jvanderberg/usb-pd/README.md

# usb-pd

A pocket USB-C PD/PPS bench supply, 67 x 17 mm. Plug it into a PD charger and pick a fixed voltage. With a PPS
charger, set any voltage from 5 to 21 V in 100 mV steps, plus a current limit. Switch the output on and off and read
volts, amps and board temperature on a tiny OLED.

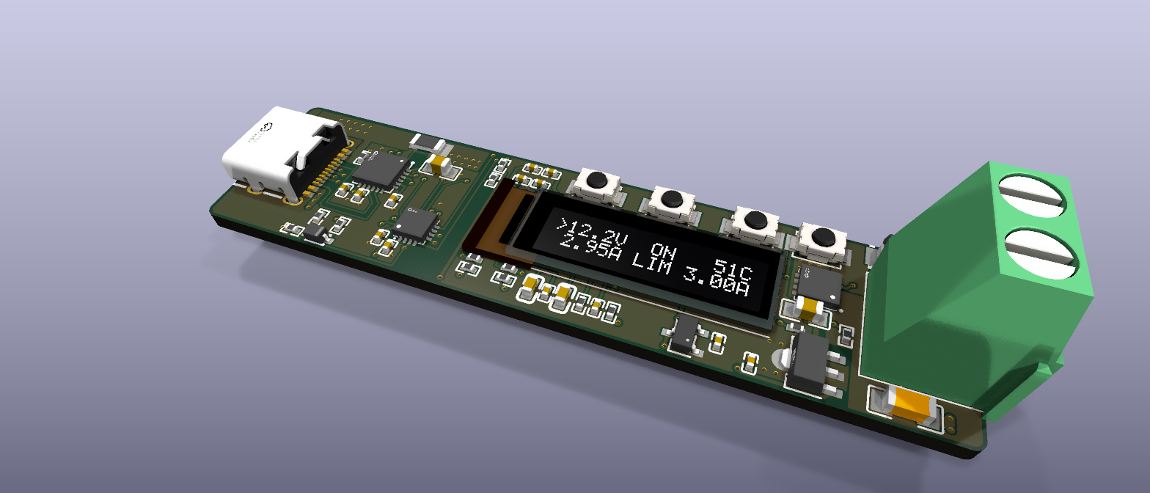
[picture p1: docs/images/board-3d.png]
3D render of the board


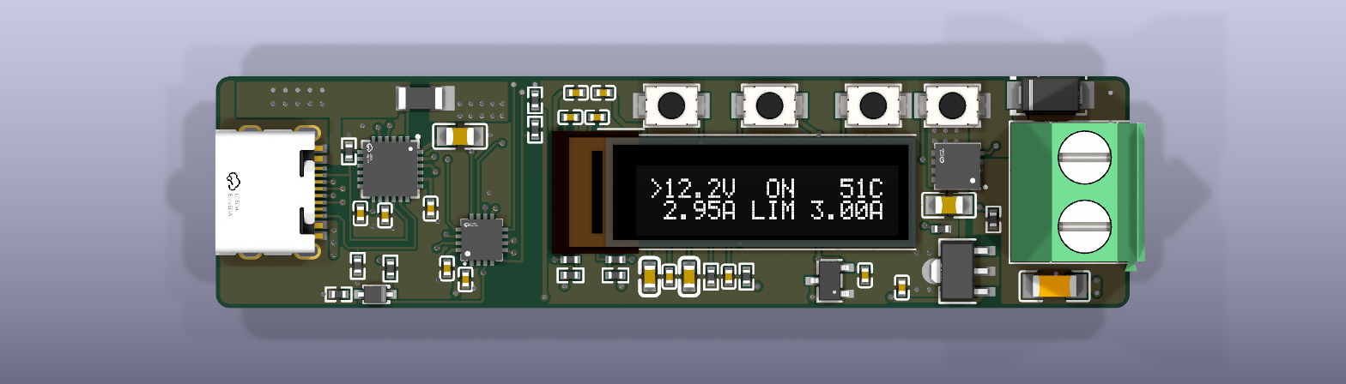
[picture p2: docs/images/board-top.png]
Top view


*KiCad 3D renders. The 0.69" OLED is hand-soldered by its flex cable and folded over onto the board. Its model
(`tools/oled_3d.py`) is built from the panel's outline drawing and shows a real frame from the firmware.*

## The screen

What the firmware draws, rendered on the host from the real UI and OLED code through a model of the panel's memory
(`cd firmware && make screens`):

| | |
|---|---|
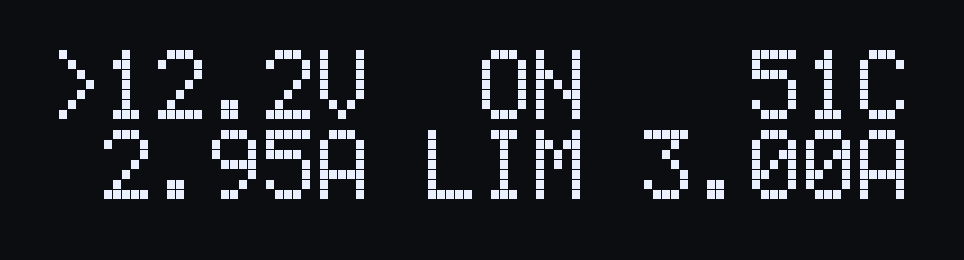
[picture p3: docs/images/screen-pps-on.png]
pps on
| PPS, output on: voltage, temperature, current, current limit |  |
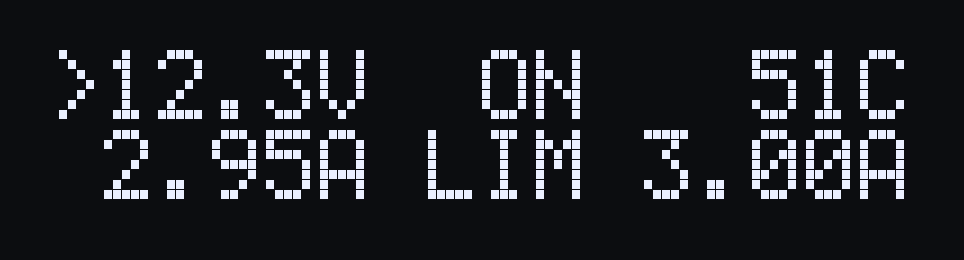
[picture p4: docs/images/screen-pps-set-v.png]
pps set v
| PPS, editing the voltage (`>` marks the value being edited) |  |
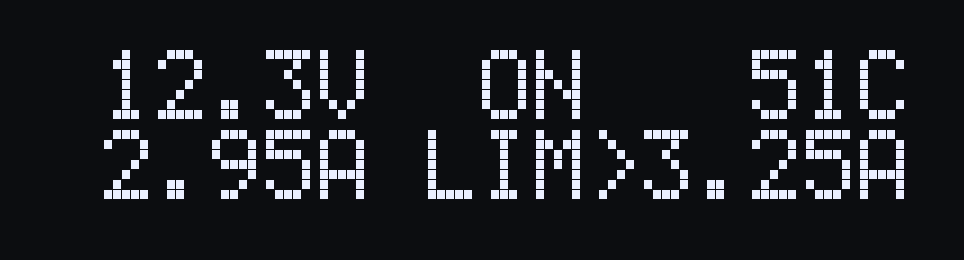
[picture p5: docs/images/screen-pps-set-i.png]
pps set i
| PPS, editing the current limit (UP + DOWN switches) |  |
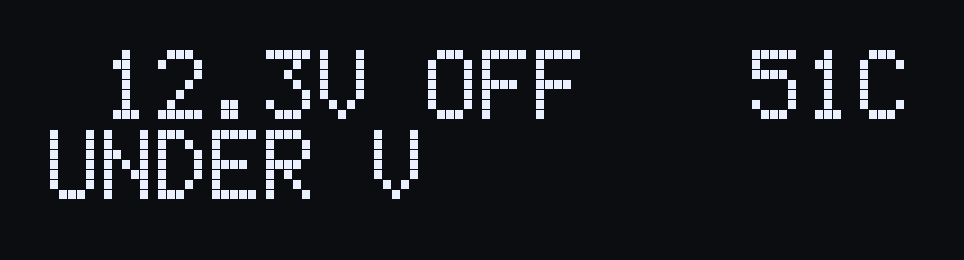
[picture p6: docs/images/screen-pps-uvp.png]
pps uvp
| PPS, undervoltage trip (e.g. the charger hit its current limit) |  |
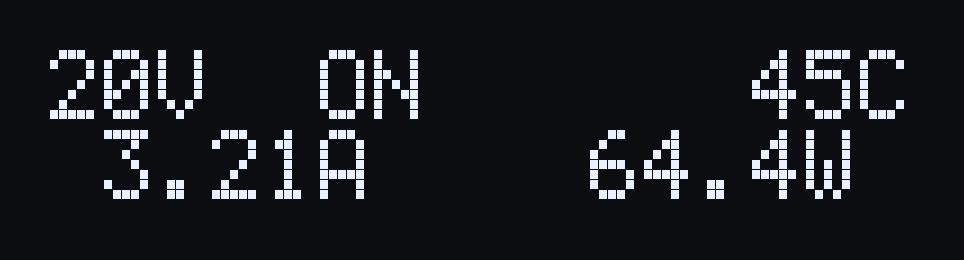
[picture p7: docs/images/screen-on.png]
on
| Fixed voltage, output on |  |
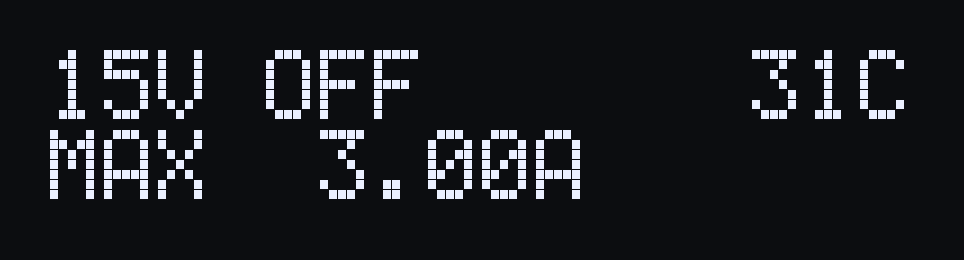
[picture p8: docs/images/screen-off.png]
off
| Fixed voltage, output off |  |
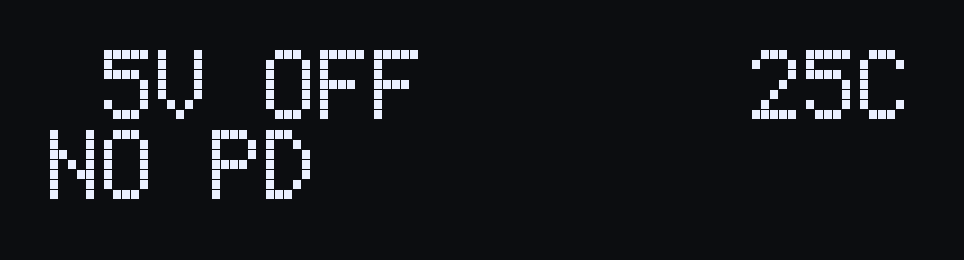
[picture p9: docs/images/screen-no-pd.png]
no PD
| No PD charger (plain 5 V) |  |
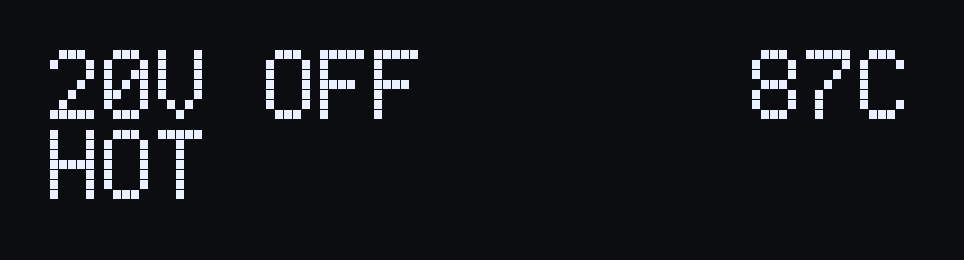
[picture p10: docs/images/screen-hot.png]
hot
| Thermal cutoff |  |
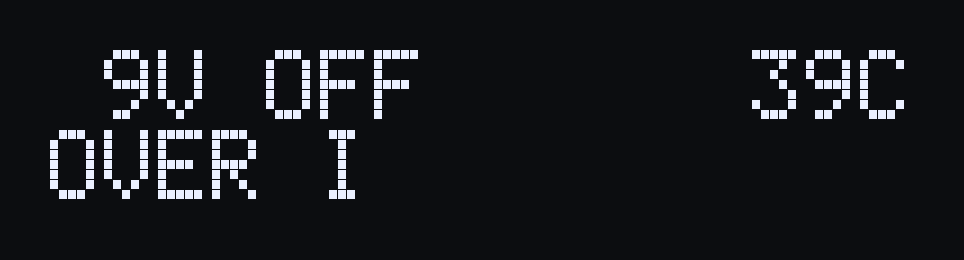
[picture p11: docs/images/screen-overcurrent.png]
over-current
| Over-current trip |  |

## What it does

- **PD sink:** AP33772S (AP33772SDKZ-13-FA02). It negotiates the charger's fixed voltages and PPS up to 21 V, and
  never requests what the charger does not offer. EPR is disabled in firmware.
- **Buttons:** four, in one row: `[ON]  [SEL]  [UP][DN]`.
  - ON switches the output on and off.
  - SEL steps through the fixed voltages the charger offers, then PPS, turning the output off first.
  - In PPS, UP / DOWN change the setpoint (hold to accelerate), and UP + DOWN together switch between voltage and
    current limit.
- **Display:** voltage, current and NTC temperature, all read from the AP33772S.
- **Memory:** remembers the last voltage or PPS setpoint and the on/off state, wear-levelled in the MCU's DataFlash.
- **Protection:** the AP33772S's OCP / OVP / UVP / OTP, plus the firmware's own thermal trip (board NTC and a
  MOSFET temperature estimate).
- **Firmware updates** over the same USB-C port (CH552 ROM bootloader).

## Hardware

- 67 x 17 mm, 2 layers, all parts on top, made for JLCPCB economic assembly.
- **ICs:** CH552P MCU and AP33772S PD sink, with SGM2203 (5 V) and XC6206 (3.3 V) regulators.
- **Output switch:** one AON7262E N-MOSFET driven by the AP33772S, with an SS34 clamp and 10 uF on the output, as on
  CentyLab's RotoPD.
- **I2C:** the MCU talks to the AP33772S on its own 5 V bus and to the OLED on a 3.3 V bus.
- **Output:** two 5.08 mm through-hole pads, for a screw terminal or wires.
- **Design method:** designed in KiCad 10 from scripts with [kicad-skills](https://github.com/jvanderberg/kicad-skills).
  The schematic, netlist, placement and routing are generated by `tools/` (`tools/build_board.sh`).

Read these before building one:
- [docs/requirements.md](docs/requirements.md): requirements, decisions, block diagram and parts.
- [docs/design-review.md](docs/design-review.md): the design review, including its main limit. The board is
  small, so 100 W continuous makes it too hot; the thermal trips are what protect it.

Production files for JLCPCB (gerbers, BOM, CPL, part check) for 10 boards are in `production/`. To regenerate them:
`jlcimport-cli production hardware/usbpd.kicad_pcb -n 10 -o production`.

## Firmware

C for SDCC, in [firmware/](firmware/). See [firmware/README.md](firmware/README.md).

```
cd firmware
make          # build/usbpd.hex and .bin
make test     # host tests
make screens  # the screen images above
make flash    # wchisp, with the board in its bootloader (hold SEL while plugging in)
```

## Status

Designed, not yet built. The board passes DRC, ERC and the design review, and the firmware passes its host tests,
but nothing has run on real hardware. Known open items before or at bring-up:
- **Firmware:** confirm that "output off" took effect by reading `SYSTEM` back, at boot and on every trip.
- **Bring-up:** measure Q1's gate drive and on-resistance, and check that JLC placed the polarised parts correctly.
- **Behaviour:** when a PPS charger hits its current limit, the output trips on undervoltage instead of holding a
  constant current.

This is a hobby project, not designed or reviewed for safety-critical use.

Created in [T3 Code](https://t3.codes).
