jvanderberg/usb-pd/production/usbpd-bom.csv

Comment | Designator | Footprint | JLCPCB Part #
1u 50V | C1,C2 | CL21B105KBFNNNE | C28323
4.7u | C3,C13 | CL05A475MP5NRNC | C23733
1u | C4,C7,C8,C15 | CL05A105KA5NQNC | C52923
100n | C5,C6,C9,C12,C14,C16,C17 | CL05B104KO5NNNC | C1525
2.2u 16V | C10 | CL10A225KO8NNNC | C23630
4.7u 25V | C11 | CL10A475KA8NQNC | C69335
10u 50V | C18 | CL31A106KBHNNNE | C13585
BAT54WS | D1 | BAT54WS_C7502694 | C7502694
SS34 | D2 | SS34_C8678 | C8678
TYPE-C-31-M-12 | J1 | TYPE-C-31-M-12 | C165948
AON7262E | Q1 | AON7262E | C176755
2.2k | R1,R2 | 0402WGF2201TCE | C25879
10k | R3,R4,R9 | 0402WGF1002TCE | C25744
5.1k | R5,R6 | 0402WGF5101TCE | C25905
4.7k | R7,R8 | 0402WGF4701TCE | C25900
5m | R10 | RLM12FTCMR005 | C316225
910k | R11 | 0402WGF9103TCE | C25800
150 | R12,R13 | 0402WGF1500TCE | C25082
27 | R14 | 0402WGF270JTCE | C25100
10k B3380 | RT1 | NCP15XH103F03RC | C77131
ON/OFF / SEL / UP / DN | SW1,SW2,SW3,SW4 | TS-1088-AR02016 | C720477
AP33772S | U1 | AP33772S_EPVIA | C50341643
SGM2203-5.0 | U2 | SGM2203-5_0YK3G_TR | C4555390
XC6206-3.3 | U3 | XC6206P332MR | C5446
CH552P | U4 | CH552P_EPVIA | C968536
