jvanderberg/usb-pd/hardware/usbpd.kicad_pcb

## KiCad design hardware/usbpd.kicad_pcb (2026-11-11)

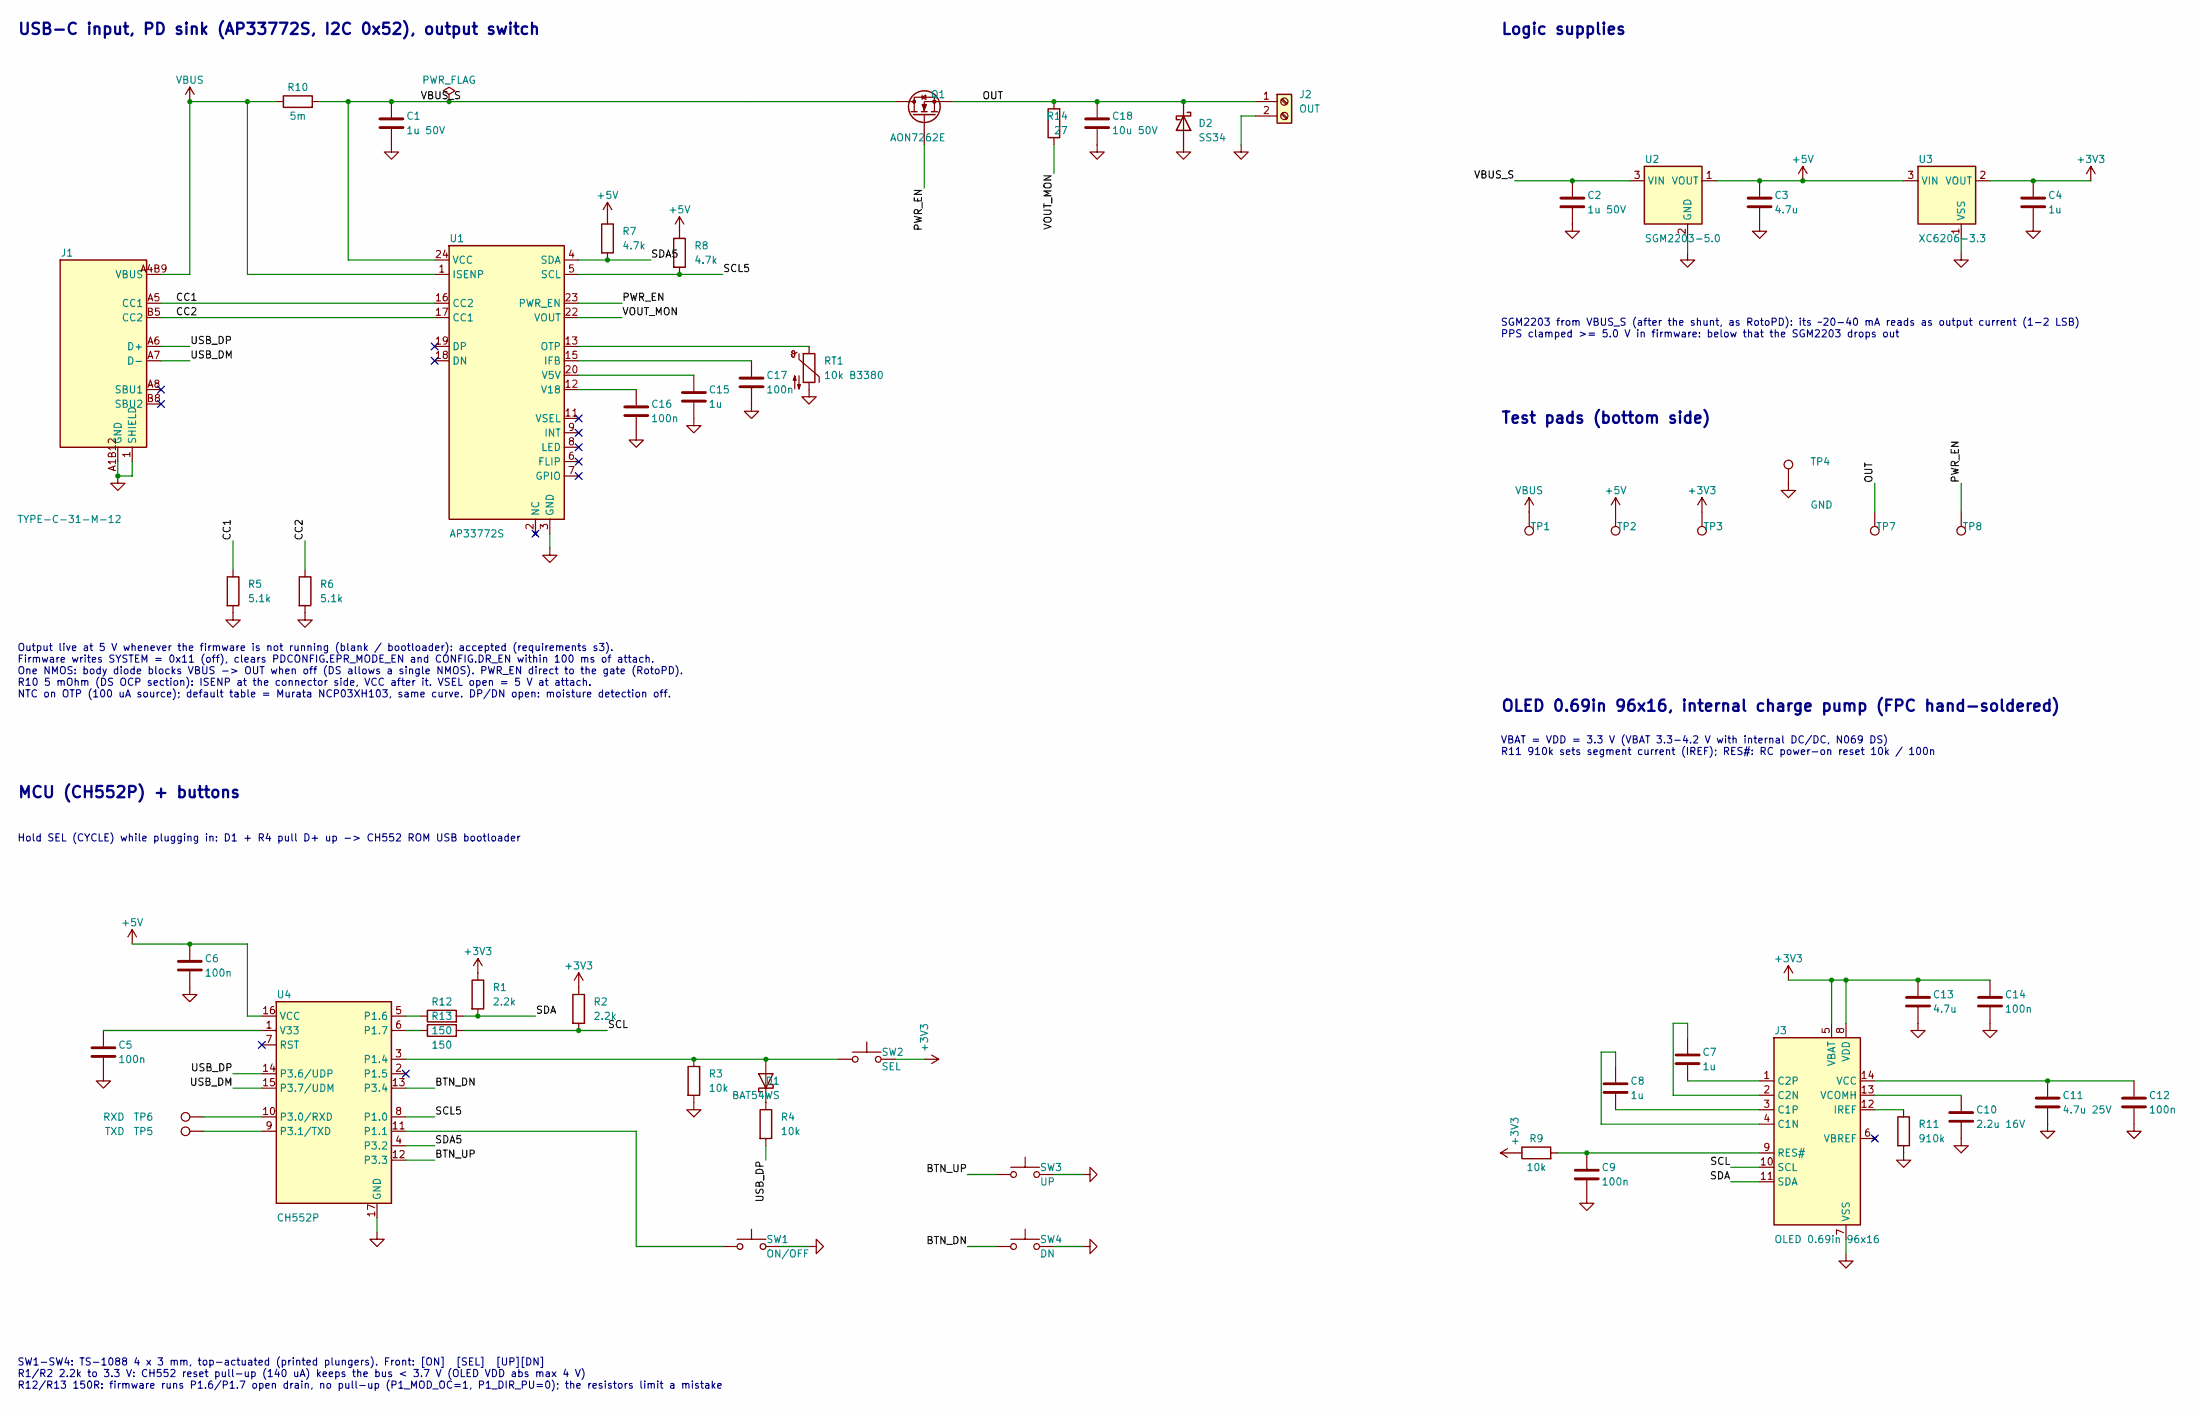
[picture p12: schematic usbpd.kicad_sch, USB-PD PPS board]

Parts:
C1, C2: 1u 50V; CL21B105KBFNNNE; LCSC C28323
C3, C13: 4.7u; CL05A475MP5NRNC; LCSC C23733
C4, C7, C8, C15: 1u; CL05A105KA5NQNC; LCSC C52923
C5, C6, C9, C12, C14, C16, C17: 100n; CL05B104KO5NNNC; LCSC C1525
C10: 2.2u 16V; CL10A225KO8NNNC; LCSC C23630
C11: 4.7u 25V; CL10A475KA8NQNC; LCSC C69335
C18: 10u 50V; CL31A106KBHNNNE; LCSC C13585
D1: BAT54WS; BAT54WS_C7502694; LCSC C7502694
D2: SS34; SS34_C8678; LCSC C8678
J1: TYPE-C-31-M-12; Manufacturer Part TYPE-C-31-M-12; LCSC C165948
J2: OUT; TerminalBlock_Phoenix_MKDS-1,5-2-5.08_1x02_P5.08mm_Horizont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
J3: OLED 0.69in 96x16; OLED_0.69in_96x16_FPC14
Q1: AON7262E; Manufacturer Part AON7262E; LCSC C176755
R1, R2: 2.2k; 0402WGF2201TCE; LCSC C25879
R3, R4, R9: 10k; 0402WGF1002TCE; LCSC C25744
R5, R6: 5.1k; 0402WGF5101TCE; LCSC C25905
R7, R8: 4.7k; 0402WGF4701TCE; LCSC C25900
R10: 5m; RLM12FTCMR005; LCSC C316225
R11: 910k; 0402WGF9103TCE; LCSC C25800
R12, R13: 150; 0402WGF1500TCE; LCSC C25082
R14: 27; 0402WGF270JTCE; LCSC C25100
RT1: 10k B3380; NCP15XH103F03RC; LCSC C77131
SW1: ON/OFF; TS-1088-AR02016; LCSC C720477
SW2: SEL; TS-1088-AR02016; LCSC C720477
SW3: UP; TS-1088-AR02016; LCSC C720477
SW4: DN; TS-1088-AR02016; LCSC C720477
TP1: VBUS; TestPoint_Pad_D1.0mm
TP2: +5V; TestPoint_Pad_D1.0mm
TP3: +3V3; TestPoint_Pad_D1.0mm
TP4: GND; TestPoint_Pad_D1.0mm
TP5: TXD; TestPoint_Pad_D1.0mm
TP6: RXD; TestPoint_Pad_D1.0mm
TP7: OUT; TestPoint_Pad_D1.0mm
TP8: PWR_EN; TestPoint_Pad_D1.0mm
U1: AP33772S; AP33772S_EPVIA; Manufacturer Part AP33772SDKZ-13-FA02; LCSC C50341643
U2: SGM2203-5.0; SGM2203-5_0YK3G_TR; Manufacturer Part SGM2203-5.0YK3G/TR; LCSC C4555390
U3: XC6206-3.3; XC6206P332MR; Manufacturer Part XC6206P332MR-G; LCSC C5446
U4: CH552P; CH552P_EPVIA; Manufacturer Part CH552P; LCSC C968536

Connections:
+3V3: C4.1, C13.1, C14.1, J3.5 (VBAT), J3.8 (VDD), R1.1, R2.1, R9.1, SW2.2, TP3.1 (1_1), U3.2 (VOUT)
+5V: C3.1, C6.1, R7.1, R8.1, TP2.1 (1_1), U2.1 (VOUT), U3.3 (VIN), U4.16 (VCC)
/BTN_DN: SW4.1, U4.13 (P3.4)
/BTN_UP: SW3.1, U4.12 (P3.3)
/CC1: J1.A5 (CC1), R5.1, U1.16 (CC2)
/CC2: J1.B5 (CC2), R6.1, U1.17 (CC1)
/OUT: C18.1, D2.1 (K), J2.1, Q1.1 (S), Q1.2 (S), Q1.3 (S), R14.2, TP7.1 (1_1)
/PWR_EN: Q1.4 (G), TP8.1 (1_1), U1.23 (PWR_EN)
/SCL: J3.10 (SCL), R2.2, R13.2
/SCL5: R8.2, U1.5 (SCL), U4.8 (P1.0)
/SDA: J3.11 (SDA), R1.2, R12.2
/SDA5: R7.2, U1.4 (SDA), U4.4 (P3.2)
/USB_DM: J1.A7 (D-), J1.B7 (D-), U4.15 (P3.7/UDM)
/USB_DP: J1.A6 (D+), J1.B6 (D+), R4.2, U4.14 (P3.6/UDP)
/VBUS_S: C1.1, C2.1, Q1.5 (D), R10.2, U1.24 (VCC), U2.3 (VIN)
/VOUT_MON: R14.1, U1.22 (VOUT)
GND: C1.2, C2.2, C3.2, C4.2, C5.2, C6.2, C9.2, C10.2, C11.2, C12.2, C13.2, C14.2, C15.2, C16.2, C17.2, C18.2, D2.2 (A), J1.1 (SHIELD), J1.2 (SHIELD), J1.3 (SHIELD), J1.4 (SHIELD), J1.A1B12 (GND), J1.B1A12 (GND), J2.2, J3.7 (VSS), R3.2, R5.2, R6.2, R11.2, RT1.2, SW1.2, SW3.2, SW4.2, TP4.1 (1_1), U1.3 (GND), U1.25 (GND), U2.2 (GND), U3.1 (VSS), U4.17 (GND)
unnamed: D1.2 (A), R3.1, SW2.1, U4.3 (P1.4)
unnamed: D1.1 (K), R4.1
unnamed: C8.1, J3.4 (C1N)
unnamed: C8.2, J3.3 (C1P)
unnamed: C7.1, J3.2 (C2N)
unnamed: C7.2, J3.1 (C2P)
unnamed: J3.12 (IREF), R11.1
unnamed: C9.1, J3.9 (RES#), R9.2
unnamed: C11.1, C12.1, J3.14 (VCC)
unnamed: C10.1, J3.13 (VCOMH)
unnamed: C17.1, U1.15 (IFB)
unnamed: RT1.1, U1.13 (OTP)
unnamed: C15.1, U1.20 (V5V)
unnamed: C16.1, U1.12 (V18)
unnamed: SW1.1, U4.11 (P1.1)
unnamed: R12.1, U4.5 (P1.6)
unnamed: R13.1, U4.6 (P1.7)
unnamed: TP6.1 (1_1), U4.10 (P3.0/RXD)
unnamed: TP5.1 (1_1), U4.9 (P3.1/TXD)
unnamed: C5.1, U4.1 (V33)
VBUS: J1.A4B9 (VBUS), J1.B4A9 (VBUS), R10.1, TP1.1 (1_1), U1.1 (ISENP)

Notes on the sheet:
USB-C input, PD sink (AP33772S, I2C 0x52), output switch
Output live at 5 V whenever the firmware is not running (blank / bootloader): accepted (requirements s3). Firmware writes SYSTEM = 0x11 (off), clears PDCONFIG.EPR_MODE_EN and CONFIG.DR_EN within 100 ms of attach. One NMOS: body diode blocks VBUS -> OUT when off (DS allows a single NMOS). PWR_EN dir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
Logic supplies
SGM2203 from VBUS_S (after the shunt, as RotoPD): its ~20-40 mA reads as output current (1-2 LSB) PPS clamped >= 5.0 V in firmware: below that the SGM2203 drops out
MCU (CH552P) + buttons
Hold SEL (CYCLE) while plugging in: D1 + R4 pull D+ up -> CH552 ROM USB bootloader
SW1-SW4: TS-1088 4 x 3 mm, top-actuated (printed plungers). Front: [ON] [SEL] [UP][DN] R1/R2 2.2k to 3.3 V: CH552 reset pull-up (140 uA) keeps the bus < 3.7 V (OLED VDD abs max 4 V) R12/R13 150R: firmware runs P1.6/P1.7 open drain, no pull-up (P1_MOD_OC=1, P1_DIR_PU=0); the resistors limit a mistake
OLED 0.69in 96x16, internal charge pump (FPC hand-soldered)
VBAT = VDD = 3.3 V (VBAT 3.3-4.2 V with internal DC/DC, N069 DS) R11 910k sets segment current (IREF); RES#: RC power-on reset 10k / 100n
Test pads (bottom side)

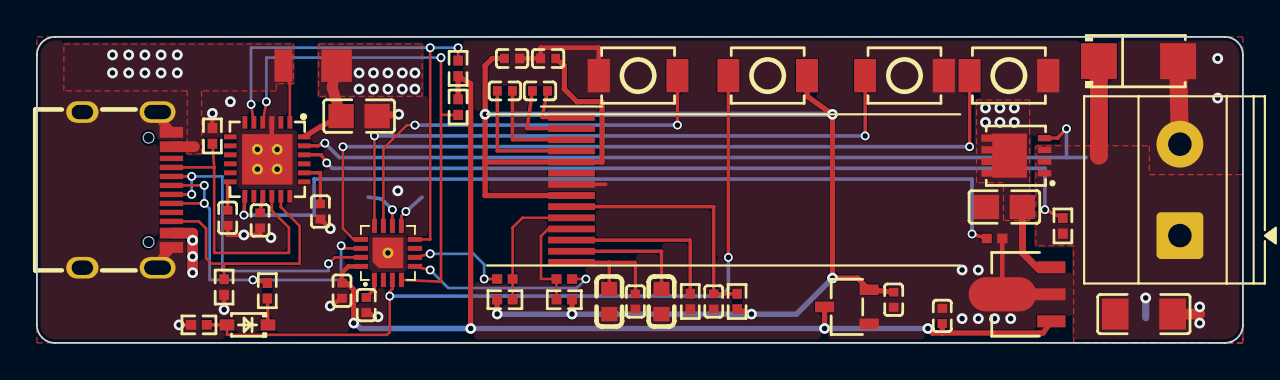
[picture p13: board usbpd.kicad_pcb from above]

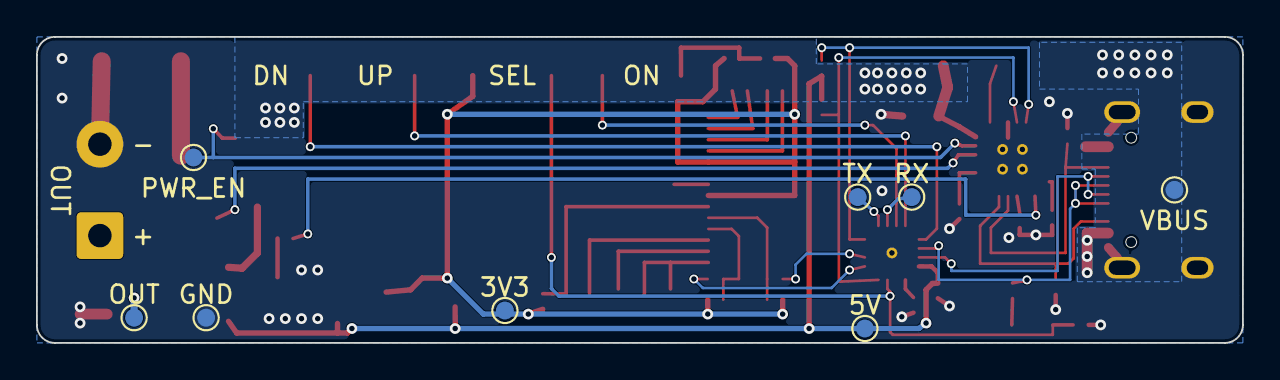
[picture p14: board usbpd.kicad_pcb from below]

Board: 2 copper layers, 67.0 x 17.0 mm, 55 parts (8 on the bottom side), 38 nets.
