jvanderberg/usb-pd/(commit log)

2026-11-11 USB-PD trigger board: requirements, parts, schematic
    HUSB238 PD sink, CH552P MCU (USB bootloader), SGM2203 + XC6206 LDOs,
    AO4407A output switch, 0.69in 96x16 OLED. Schematic generated by
    tools/schematic.py; netlist checked against tools/nets.py, ERC clean.
    [usbpd.kicad_sch]
2026-11-11 Board layout: placement and full route plan (67 x 17 mm, 2 layers)
    - tools/place.json, tools/route_plan.py, tools/labels.json: placement, every
    track/via/pour as data; tools/build_board.sh rebuilds the board from the
    schematic and stops at the first failed stage
    - Bottom VBUS band J1 -> Q1, top VOUT pour, GND pours; nothing under the
    folded OLED panel (OLED caps / RES network moved above and below it)
    - MCU pin map: ON/OFF P1.1, CYCLE P1.4, SW_EN P1.0 (P1.5 kept free)
    - usbpd:CH552P_EPVIA: JLC footprint with a GND via in the exposed pad and
    paste windows clear of it
    - DRC 0 errors, 0 unconnected, parity clean, ERC 0, board lint 0
    - requirements: board size, power-path layout, OLED so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
    [usbpd.kicad_pcb, usbpd.kicad_sch]
2026-11-11 Add INA226 power monitor with 5 mOhm Kelvin shunt on the output
    R10 (RLM12FTCMR005, 1206) between Q1's drains and J2; output copper split
    into VOUT_SW and VOUT pours. U5 (INA226, I2C 0x40) in the bottom strip
    with Kelvin sense traces, C15 decoupling; I2C via two bottom rows under
    the OLED. SW2 moved 1.5 mm left. R10 uses an outline-free copy of JLC's
    footprint (NoOutline.pretty). Requirements updated.
    [usbpd.kicad_pcb, usbpd.kicad_sch]
2026-11-11 Design review fixes: NTC board temperature, I2C series resistors, shunt land, U2 tab vias
    - RT1 NTC 10k B3380 + R11 2.2k on P3.2/AIN3 for a firmware over-temperature cutoff
    - R12/R13 220R in the CH552's SDA/SCL branch (5 V MCU on a 3.3 V bus); R1 moved onto the SDA row
    - R10 pads per the RLM12 datasheet land (pad 1 shortened next to Q1), Kelvin taps at the inner edges
    - 3 GND vias below U2's tab
    - docs/design-review.md and docs/review_config.json (kicad-board-review)
    [usbpd.kicad_pcb, usbpd.kicad_sch]
2026-11-11 Firmware, NTC from +5V, 150R I2C series resistors
    - firmware/: CH552P firmware (SDCC). HUSB238 contract handling (never requests an unoffered
    voltage, restores the saved voltage/on state only when offered), ON/CYCLE buttons debounced
    in a 1 ms ISR, INA226 volts/amps/watts, NTC board temperature plus an I^2 Q1 estimate for
    the thermal cutoff, over-current trip against the contract, DataFlash settings log
    (32-slot wear levelling), watchdog, bootloader button combo.
    - 16 MHz clock (datasheet allows it down to VCC 3.8 V); 16-bit shift-add arithmetic in place
    of SDCC's 32-bit helpers (display update CPU 1.27M -> 177k 8051 clocks).
    - OLED: partial flush of changed spans only (30 bytes fo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
    [usbpd.kicad_pcb, usbpd.kicad_sch]
2026-11-11 Align SW1 with SW2 (both at x 39.5) so the case plungers line up
    SW2 was moved 1.5 mm left for the INA226's I2C lanes and SW1 was not moved with it.
    [usbpd.kicad_pcb]
2026-11-11 OLED 3D model and rendered screen images
    - tools/oled_3d.py: VRML model of the folded 0.69" panel (glass, polarizer, COG IC, FPC
    fold) from the N069 outline drawing, showing a real firmware frame; linked from the
    OLED footprint.
    - firmware: screen text moved to logic.c ui_lines() so the host can render it;
    test/screens.c + tools/screens.py (make screens) draw each screen state through the
    real oled.c and a panel RAM model at the panel's pixel pitch.
    - README: new renders and a gallery of the screens.
    [usbpd.kicad_pcb]
2026-11-11 Pre-order review: C3 4.7 uF, no paste on OLED FPC pads, production files
    - C3 (SGM2203 output) 1 uF -> 4.7 uF 0402 (C23733): the SGM2203 needs 1-10 uF effective
    output capacitance; a 1 uF 0402 keeps ~0.5 uF at 5 V bias.
    - OLED FPC pads (J3) without solder paste: the FPC is hand-soldered after assembly, and
    stencil paste on the unplaced 0.62 mm-pitch pads would reflow into bridges.
    - production/: Gerbers, BOM, CPL and the JLC check report (10 boards, global stock).
    - docs/design-review.md: pre-order review results and first-board test list.
    [usbpd-bom.csv, usbpd.kicad_pcb, usbpd.kicad_sch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]
2026-11-11 v2 requirements: PPS board with AP33772S, 4 buttons, no INA226
    Adds docs/requirements-v2.md alongside v1: AP33772S-FA02 PD sink (PPS, 100 mV /
    0.25 A steps, PPS clamped to 5-21 V), AON7262E NMOS switch driven from PWR_EN,
    V/I/temperature from the AP33772S, 4-button UI ([ON] [SEL] [UP][DN]), and the
    AP33772S on its own 5 V I2C bus. Register fields not in the datasheet are
    cross-checked against two independent drivers. Adds the AP33772S Rev 10-2 and
    AON7262E datasheets.
2026-11-11 v2 PPS board: schematic, layout, design review, firmware
    - v2/hardware: AP33772S-FA02 PPS sink, single AON7262E switch, 4 buttons, 67 x 17 mm,
    routed from v2/tools (place.json, route_plan.py); DRC/ERC/parity clean, zones filled on build
    - v2/docs: design review (thermal M1 with Q1 at the real gate drive), review config, pin decisions
    - v2/firmware: AP33772S driver on the 5 V bit-banged bus, fixed + PPS UI with hold-to-accelerate,
    current-limit editing, faults, settings log; host tests and screen renders
    [usbpd2.kicad_pcb, usbpd2.kicad_sch]
2026-11-11 v2 production files: gerbers, BOM, CPL, JLC part check (10 boards)
    [usbpd2-bom.csv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]
2026-11-11 v2: output Schottky clamp D2 (SS34) and 10 uF bulk C18, as RotoPD; production files regenerated
    [usbpd2-bom.csv, usbpd2.kicad_pcb, usbpd2.kicad_sch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]
2026-11-11 README: add the v2 PPS board, with board renders and screens
    - README: v2 section (renders, firmware screens, what changed, files, status and open bring-up items)
    - v2/docs/images: KiCad 3D and top renders of usbpd2
    - v2/hardware/production: JLC export for 5 boards (same board as v2/production)
    [usbpd2-B_Cu.gbl, usbpd2-B_Mask.gbs, usbpd2-B_Paste.gbp, usbpd2-B_Silkscreen.gbo, usbpd2-Edge_Cuts.gm1, usbpd2-F_Cu.gtl, usbpd2-F_Mask.gts, usbpd2-F_Paste.gtp]
2026-11-11 v2: OLED 3D model shows a v2 PPS frame; renders regenerated
    v2/tools/oled_3d.py: v1's generator with v2 paths and the pps-on frame from v2/firmware/test/screens.c
2026-11-11 README: describe only the PPS board
2026-11-11 Make the PPS board the project; delete the fixed-voltage board
    - Delete the old HUSB238 board (hardware, firmware, tools, docs, production files) and its parts
    (HUSB238, INA226, AO4407A, 2N7002, RLP25 footprints, symbols, 3D models, datasheets)
    - Move v2/* to the top level; usbpd2.* -> usbpd.*; requirements-v2.md -> requirements.md
    - Docs and comments describe the board on its own (no "as v1" references)
    - Schematic title "USB-PD PPS board", rev 1
    - Production files regenerated for 10 boards (BOM and CPL unchanged)
    [usbpd-B_Cu.gbl, usbpd-B_Mask.gbs, usbpd-B_Paste.gbp, usbpd-B_Silkscreen.gbo, usbpd-Edge_Cuts.gm1, usbpd-F_Cu.gtl, usbpd-F_Mask.gts, usbpd-F_Paste.gtp]
